2201102/G474re_v2/README.md

G474reのロボット用メイン基板
# 機能
- ST-Link×1
- USART×1
- I2C×1
- CANFD×1
- USB×1
- エンコーダー×4
- モーター×4
- 汎用入出力×5

# USB書き込みの方法
BOOTボタンを押しながらリセットをすることでブートローダーが起動し、USB書き込みが行えるようになる。
CubeProgrammerでUSB接続を選択し、コンパイルした.elf/.binを書き込む
