2201102/G474re_v2/g474re_testboard_v2.ioc

Mcu.UserName=STM32G474RETx
PA0.Signal=GPIO_Output
PA1.Signal=GPIO_Output
PA10.Signal=GPIO_Output
PA11.Signal=USB_DM
PA12.Signal=USB_DP
PA13.Signal=SYS_JTMS-SWDIO
PA14.Signal=SYS_JTCK-SWCLK
PA15.Signal=S_TIM2_CH1
PA2.Signal=USART2_TX
PA3.Signal=USART2_RX
PA4.Signal=S_TIM3_CH2
PA5.Signal=GPIO_Output
PA6.Signal=S_TIM3_CH1
PA7.Signal=GPIO_Output
PA8.Signal=I2C2_SDA
PA9.Signal=I2C2_SCL
PB0.Signal=GPIO_Output
PB11.Signal=GPIO_Output
PB12.Signal=FDCAN2_RX
PB13.Signal=FDCAN2_TX
PB14.Signal=GPIO_Output
PB15.Signal=GPIO_Output
PB2.Signal=S_TIM20_CH1
PB3.Signal=SYS_JTDO-SWO
PB6.Signal=S_TIM4_CH1
PB7.Signal=S_TIM4_CH2
PB8-BOOT0.Signal=FDCAN1_RX
PB9.Signal=FDCAN1_TX
PC0.Signal=S_TIM1_CH1
PC1.Signal=S_TIM1_CH2
PC10.Signal=GPIO_Input
PC11.Signal=GPIO_Input
PC12.Signal=GPIO_Input
PC13.Signal=GPIO_Input
PC15-OSC32_OUT.Signal=GPIO_Output
PC2.Signal=S_TIM20_CH2
PC4.Signal=USART1_TX
PC5.Signal=USART1_RX
PC6.Signal=S_TIM8_CH1
PC7.Signal=S_TIM8_CH2
PC8.Signal=S_TIM3_CH3
PC9.Signal=S_TIM3_CH4
PD2.Signal=GPIO_Output
PF0-OSC_IN.Signal=RCC_OSC_IN
PF1-OSC_OUT.Signal=RCC_OSC_OUT
