2201102/G474re_v2/(commit log)

2026-05-14 Add title for main board in README
2026-05-14 修正テスト
    [G474re_testboard_v2.kicad_pcb]
2026-05-16 iocファイルを追加
2026-05-19 余計な抵抗を削除
    [G474.kicad_sch, G474re_testboard_v2.kicad_pcb]
2026-06-24 変更テスト
    [power.kicad_sch]
